EmpWorks/DisciplineV1.2/back.PNG

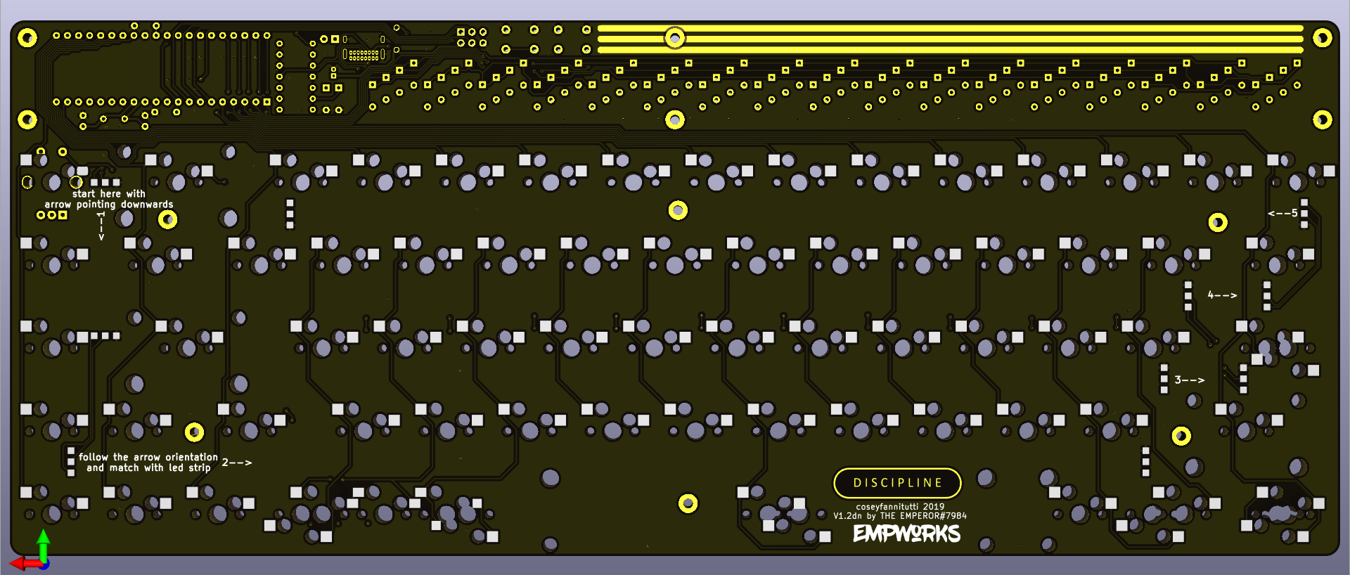
back.PNG
