EmpWorks/DisciplineV1.2/front.PNG

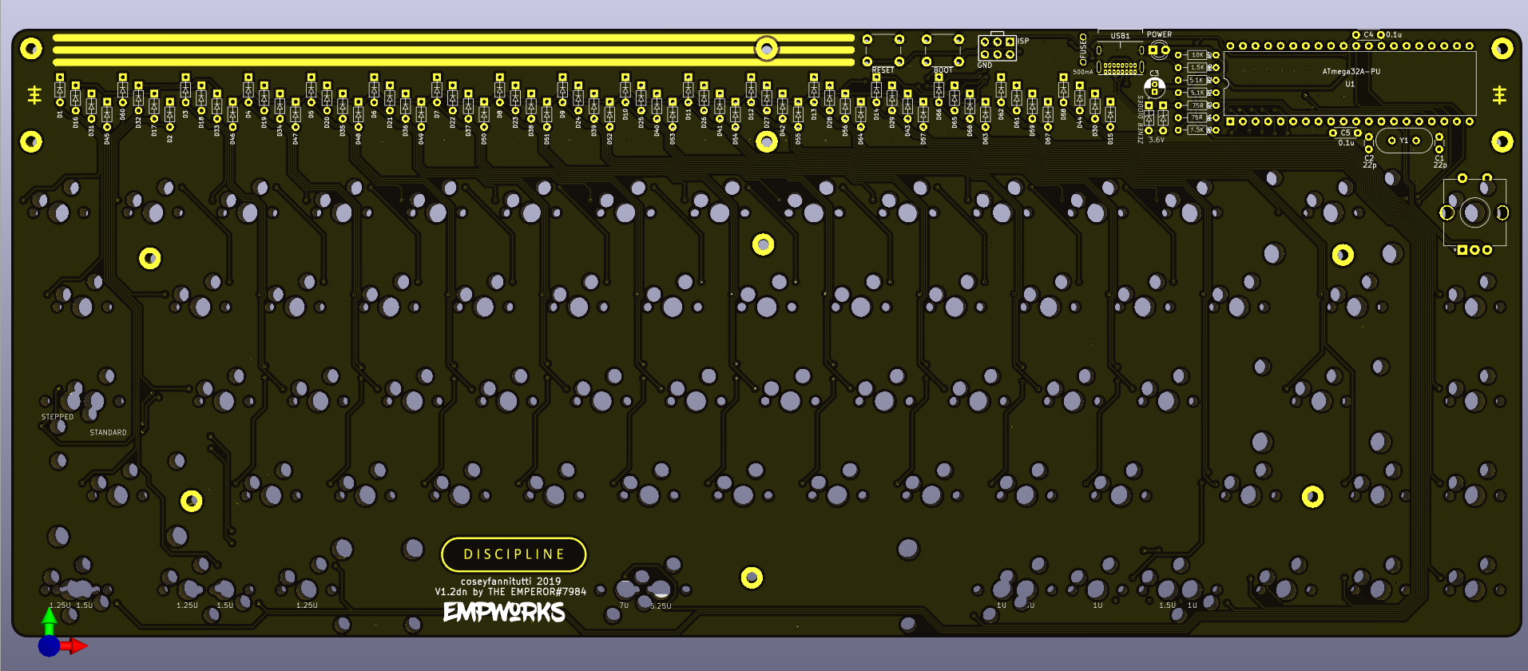
front.PNG
