EmpWorks/DisciplineV1.2/referernce pics/maxresdefault.jpg

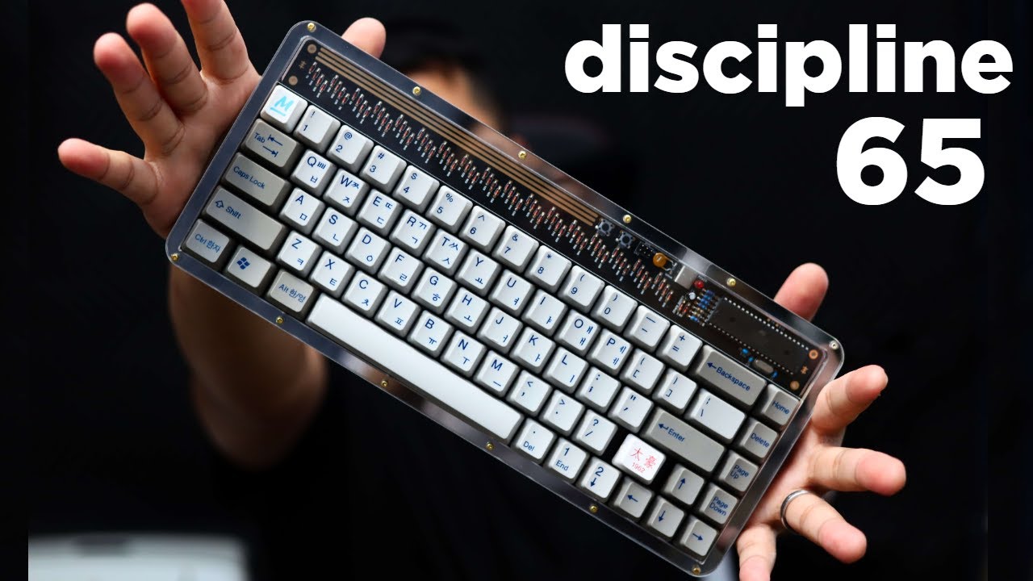
referernce pics/maxresdefault.jpg
