EmpWorks/DisciplineV1.2/acrylic-case/discipline-foot-1.dxf

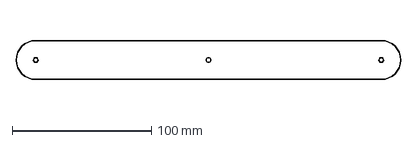
[picture p5: CAD file, 2022-04-10]
acrylic-case/discipline-foot-1.dxf
276.5 x 28.0 mm
