EmpWorks/DisciplineV1.2/acrylic-case/discipline-plate.dxf

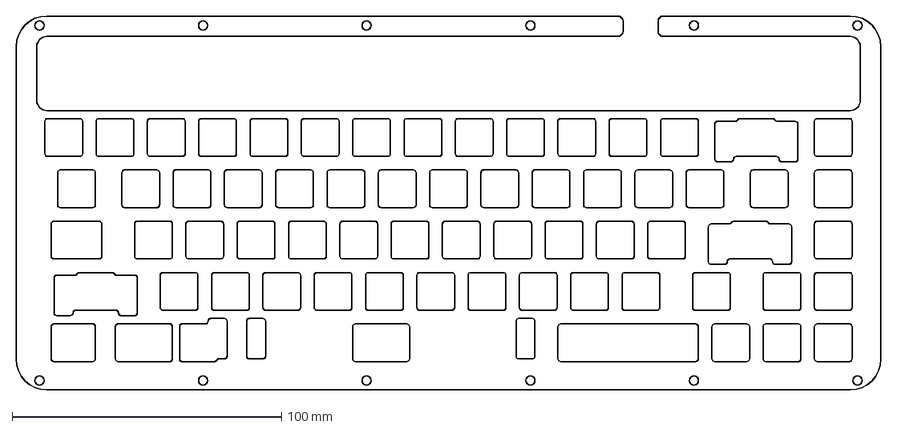
[picture p6: CAD file, 2022-04-10]
acrylic-case/discipline-plate.dxf
320.9 x 138.8 mm
