EmpWorks/DisciplineV1.2/acrylic-case/discipline-foot-3.dxf

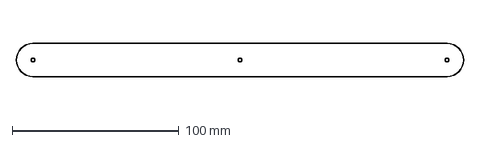
[picture p7: CAD file, 2022-04-10]
acrylic-case/discipline-foot-3.dxf
268.5 x 20.0 mm
