EmpWorks/DisciplineV1.2/acrylic-case/discipline-top1.dxf

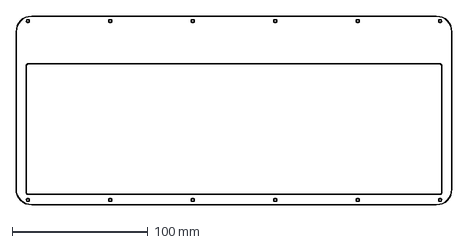
[picture p8: CAD file, 2022-04-10]
acrylic-case/discipline-top1.dxf
320.9 x 138.8 mm
