EmpWorks/DisciplineV1.2/acrylic-case/discipline-bottom.dxf

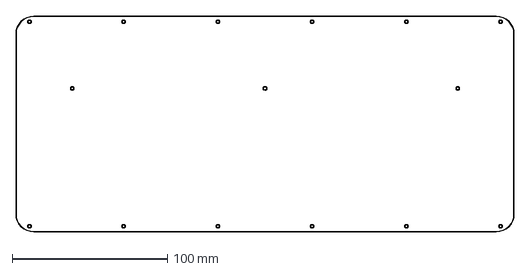
[picture p9: CAD file, 2022-04-10]
acrylic-case/discipline-bottom.dxf
320.9 x 138.8 mm
