EmpWorks/DisciplineV1.2/acrylic-case/discipline-open-layer.dxf

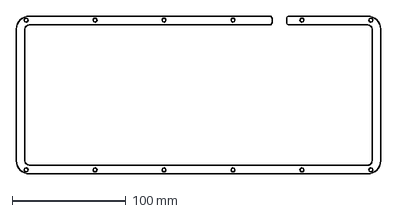
[picture p10: CAD file, 2022-04-10]
acrylic-case/discipline-open-layer.dxf
320.9 x 138.8 mm
