EmpWorks/DisciplineV1.2/acrylic-case/discipline-closed-layer.dxf

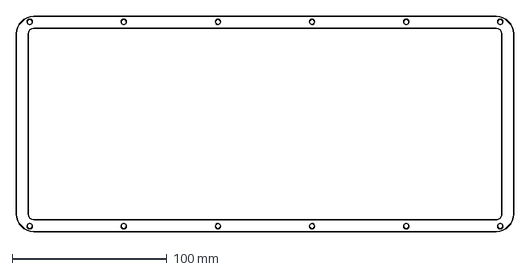
[picture p11: CAD file, 2022-04-10]
acrylic-case/discipline-closed-layer.dxf
320.9 x 138.8 mm
