EmpWorks/DisciplineV1.2/acrylic-case/discipline-foot-2.dxf

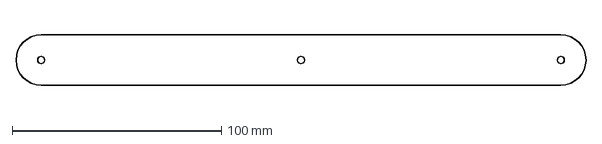
[picture p12: CAD file, 2022-04-10]
acrylic-case/discipline-foot-2.dxf
272.5 x 24.0 mm
